Eisbaeeer/Ferraris_MQTT_Energy_Counter_Meter_TCRT5000/(threads)

Thread 1 (2021-02-12):

Lolin V3 freeze

Obsthaendler, 2021-02-12:
Ab und zu friert der esp ein. Dann muss ich immer ein reset machen. Könnte es sein das der eprom Speicher voll läuft?
Nutze einen NodeMCU Lolin V3 Module ESP8266 ESP-12F WIFI

Eisbaeeer, 2021-02-12:
Bisher habe ich keine Probleme feststellen können. Die Counter laufen ohne Watchdog. Und ich bekomme ständig die aktuellen Daten. Bisher konnte ich keine Differenz zu den mechanischem Zähler feststellen. Compiliert wurde mit NodeMCU v.1.0 obwohl auch hier schon die V.3 im Einsatz ist.

Obsthaendler, 2021-02-16:
Danke für die Antwort. Dann muss ich mal auf die Suche gehen, eben hatte ich sogar nach einem Stromreset wieder ein freeze.

Closed 2021-11-12.

Thread 2 (2022-01-21):

Use better MQTT format and announce the device

rmeissn, 2022-01-21:
I'm using mosquitto as a MQTT broker and homeAssistant (HA) for home automation. HA wasn't able to auto discover the energy meter, as it won't announce itself over MQTT and is not using json to report itself as a device (or 4 devices). I had to fiddle with config files and parsing of announces values to get correct entities into HA.
It would be really helpful to announce your device over MQTT and use json to transmit the recorded values. You can find examples at: https://www.home-assistant.io/docs/mqtt/discovery/

Eisbaeeer, 2022-10-17:
Added with last pull-request.

Closed 2022-10-17.

Thread 3 (2022-01-21):

Hide MQTT password

rmeissn, 2022-01-21:
Whenever I visit the config page, the MQTT password is revealed as plain text. It would be more practical to hide the password once it was saved, as other devices are doing this too.

Eisbaeeer, 2022-10-17:
Solved

Closed 2022-10-17.

Thread 4 (2022-01-21):

Add a power per day value

rmeissn, 2022-01-21:
The device is exposing the current energy flow (as kW - it would be more useful to announce it as W) and how much energy has been used since it was installed (as kWh). Providing a daily count would be useful too (in kWh), which resets itself to 0 at 00:00 AM.

Thread 6 (2022-09-14):

Huge spikes in the measured kW

m-kloeckner, 2022-09-14:
Thank you for this project! I tried to achieve the same with ESPHome, but failed to calibrate the sensor. The dashboard with the analog sensor really helps with that.

However, I am still facing issues with bouncing. Sometimes one round results in a spike of the measured kW. See screenshot from my sensor in Home-Assistant.

I already tried adjusting the poti and the debouncing time for the sensor in the configuration. But it's hard to test because the spike only happen sporadically.

How can I best avoid these spikes?
Higher debouncing time? Lower debouncing time?

Thank you!

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

Eisbaeeer, 2022-09-14:
Hallo
Zu diesem Projekt gibt es einen Thread. Dort wird auch auf dieses Problem eingegangen. Grundsätzlich kann man sagen, dass es an dem Sensor liegt. Der Spike entsteht nicht beim Wechsel von rot auf silber, sondern irgendwann zwischendrin. Meist hilft nur, den Sensor mit Bauteilen zu verändern, damit der die Marke sauber erkennt.
Hier der Thread: https://forum.iobroker.net/topic/35404/ferraris-z%C3%A4hler-mit-tcrt5000-und-esp8266
Grüße Lars

m-kloeckner, 2022-09-14:
Danke! Das mit dem Schmitt-Trigger hatte ich auch schon gelesen - führt wahrscheinlich kein Weg dran vorbei. Muss ich allerdings welche bestellen.

Alternativ werde ich mal versuchen den Analog-Ausgang zu nutzen (ich brauche nur einen Zähler am D1 Mini). Ob das besser funktioniert wird sich zeigen: https://github.com/lrswss/esp8266-wifi-power-meter

w00dst0ck, 2022-09-14:
Du könntest Alternativ auch mal diesen Sensor probieren. Hatte damit sehr gute Ergebnisse.
https://forum.iobroker.net/topic/35404/ferraris-z%C3%A4hler-mit-tcrt5000-und-esp8266/367?_=1663145229229

Ich habe zwar mittlerweile einen Digitalen Stromzähler, aber auch da nutze ich den Sensor mit Tasmota um die Datenschnittstelle auszulesen.

m-kloeckner, 2022-09-16:
Kurzes Update: Der oben verlinkte Code läuft nun seit 2 Tagen sehr stabil ohne Hardware-Modifikationen über A0. Vielleicht hilft das jemanden, der nur einen Sensor braucht und mit den digitalen Signalen des TCRT5000 Probleme hat.

Thread 10 (2022-10-16):

Refactor for more flexibility

ss89, 2022-10-16:
Currently for each new meter we want to add, we do need to add a lot of code.

This should be more flexible in my opinion, as in the easiest case i should only have to raise the number of meters and recompile my firmware (maybe not even that?). Depending on the setup of the pins, we'd have to predefine all possible meter to pin configurations.

If we ignore the most flexible way, then i could think of some pre-compiler stuff and we'd be good.

Maybe there is an even smarter way, that doesn't even need pre-compiler magic?

Eisbaeeer, 2022-10-17:
The framework allow flexible pin definitions. Perhaps we can define the pin definitions by dropdown selection. The project starts with one meter. The additional meters where requested by users. Actually there was no user with more the 4 requested. I don´t know if there is a user with >4 ?

ss89, 2022-10-17:
I've seen the history of the project (at least from the iobroker forum entries) and i saw that someone requested 7 meters (which i think should be possible?) here: https://forum.iobroker.net/topic/35404/ferraris-z%C3%A4hler-mit-tcrt5000-und-esp8266/17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
If i see the wiring correctly, then i only need to connect all modules to the same ground and have the digital pin go to an individual pin on the board. For the wemos d1 mini that'd be 9 digital pins => 9 potential meters i could read.
Am i wrong?

I guess a dropdown allows the configuration to be as flexible for the user as possible, i don't know if there is any input validation on the web stuff though. Yet another construction site that i haven't digged into too much 🙈

EtlamGit, 2023-01-22:
I started with refactoring, progress can be followed here:
https://github.com/EtlamGit/Ferraris_MQTT_Energy_Counter_Meter_TCRT5000/tree/refactoring-2023

1) move code into multiple files
2) en-capsule a single Ferraris meter into own class
3) -> enable easy change of number of Ferraris meters

Selection will be at compile time as IOT Framework does not allow dynamic web pages.

Thread 11 (2022-10-16):

Unit of meters should be configurable

ss89, 2022-10-16:
IMHO the unit of the meters should be configurable, so that the end-user can decide which meter they are reading.

In my case I want to put the device in a room where i have one of each:
* power meter
* gas meter
* water meter

Eisbaeeer, 2022-10-17:
Thank´s for pull-request!

ss89, 2022-10-17:
This is a feature request, not a PR 🙈

ss89, 2022-10-17:
Please re-open, because it doesn't let me do it

Eisbaeeer, 2022-10-17:
reopen ;-)

ss89, 2022-10-18:
I am kind of out for this project.
My sensors arrived (mostly damaged).
My energy meter ist not being recognized well enough because in front of the meters glass there is another one from a box of my energy provider and my water meter/gas can also not be read.
Seems i'd have to use some ocr to read it, but i don't believe that is the right way.
Guess i'm waiting until i get smarter meters.

Eisbaeeer, 2022-10-19:
Arghh. Ok. Im out, too. I get smart meters next week. But this project helps others with Ferraries meters.

ss89, 2022-10-20:
Nice! For me there is no ETA yet for getting smart meters

Thread 13 (2022-11-27):

meter counter overflow

Gelbwichtel, 2022-11-27:
Hi, tolles Projekt, schade dass ich erst jetzt darauf gestoßen bin.
Ich hab gerade festgestellt, dass ich mit den kWh von meinem Zähler nicht arbeiten kann, denn dies führt zum Zahlenüberlauf.
Ich muss von **2218269** die beiden ersten Stellen weglassen, damit der Wert noch in einen **int32_t** passt.

Hi, great project, too bad I only came across it now.
I just realized that I can't work with the kWh from my meter, because this leads to number overflow.
I have to leave out the first two digits from **2218269** so that the value still fits into an **int32_t**.

cu
Gelbwichtel

Eisbaeeer, 2022-11-27:
Hi
Du kannst die Variable in der configuration.json einfach größer wählen.
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
Neu compilieren und dein Zählerstand sollte reinpassen.

Gelbwichtel, 2022-12-03:
funktioniert. Danke

Closed 2022-12-03.

Thread 14 (2022-12-12):

NodeMCU disconnect after some time

Bytechanger, 2022-12-12:
For some reason the NodeMCU stop working.
After a while (days) it stops sending data over MQTT and isn´t connected to wlan.
An other device (NodeMCU other firmware at same position) is working well for months.

Eisbaeeer, 2022-12-12:
Hello Bytechanger
This issue is not software related. Please check your MCU or antenna.

Thread 16 (2022-12-13):

0.93 under Dashbord: There are no items defined in the JSON file

bernemer, 2022-12-13:
Hi Eisbaeeer,
under dashbord i get the message : There are no items defined in the JSON file
There is no configuration.

Is there somthing missing in the bin or did i make a mistake?

Eisbaeeer, 2022-12-13:
Are you able to compile the project by yourself with platformio? I think the react enviroment is missing. In this case there is no web-part compiled.

bernemer, 2022-12-13:
At the moment i work with the Ardurino IDE.
Then i will install platformio in in the holidys and test it.

mariusgrams, 2022-12-24:
Same here, not fixed yet

Thread 17 (2023-01-08):

Deaktivierung von unnötigen Zählern

interceptor70, 2023-01-08:
Hallo ich habe mal eine frage ich habe nur einen Zähler und bekomme immer alle angezeigt

gibt es eine Möglichkeit die unnötigen zu deaktivieren ?

LG Gerrit

Eisbaeeer, 2023-01-08:
Es werden immer alle 4 Zähler angezeigt. Spielt aber keine Rolle, da die unbenutzen das System nicht belasten.

Closed 2023-01-08.

Thread 19 (2023-01-24):

OLED

interceptor70, 2023-01-24:
Hallo

Währe es möglich ein OLED Display mit einzubinden

LG Gerrit

EtlamGit, 2023-01-27:
Hallo Gerrit!

Was möchtest Du denn auf dem Display darstellen?

Der Sinn in diesem Projekt ist, den aktuellen Verbrauch zu "zählen" und an einen MQTT-Server zu schicken. Von diesem MQTT-Server kann dann jeder beliebige MQTT-Client die Daten abrufen und auf Wunsch auch auf einem Display anzeigen. Das wäre also ein ESP im dunklen Zählerschrank zum Zählen und ein anderer an gut sichtbarer Stelle mit Display.

interceptor70, 2023-01-28:
zum Beispiel den Sensor zum Einstellen  wäre ja super oder ?
und dann die Sensoren im Wechsel den aktuellen wert

EtlamGit, 2023-01-30:
Zum Einstellen habe ich einfach das Handy daneben gelegt. Genau dafür ist ja das Dashboard da.

Ansonsten gibt es diese Probleme:
* es sind alle Pins reserviert (max 7 Zähler werden unterstützt)
* ich besitze kein Display zum Testen

Thread 22 (2023-02-01):

Support of two TRCT5000 devices per meter to detect direction of meter disc

huckes, 2023-02-01:
With installed solar panels it might happen that the Ferraris Meter runs in reverse order as energy is fed into the electric net if the panels provide more energy as consumed locally. So far the project does not detect the direction change and the energy supplied is counted as consumtion.

With two TCRT5000 modules the rotating direction of the meter disk can be detected by evaluating the detection sequence of the disc mark. This should result in either a message reporting the direction or a negative value of the power calculated or both.

As this project supports several meters with a TCRT-module per each, one approach could be to combine the detection of two TCRT-modules mounted to the screen of one meter.

I already developed a design how to mount two TCRT5000 modules to the meter screen. You can find it in https://www.thingiverse.com/thing:5820811

EtlamGit, 2023-02-01:
Yes, very important note with reverse rotation.
You printed 3D design prevents reading the meter manually. So it might me better to change orientation for both to the bottom or I even read that some people use the sensors in 90°. Have you tested something like that?

A problem I see with supporting two rotation directions is: how to design the configuration dialog?
Because now, each meter is configured separately. When two are combined, we either loose half of the supported number or need some complicated UI. Any ideas how to do that?

huckes, 2023-02-02:
Thanks for your comment and the hint that the plate covers the meter. I posted an additional design on Thingiverse, where the meter can be read. In my case there are two totalizers (day/night-time). The lower totalizer can be read from the side.

Yes, I used the modules as delivered. A hysteresis could make it easier for this project.

I found a schematic of the sensor here: https://www.hotmcu.com/ir-reflective-sensor-tcrt5000-p-184.html
In the schematic the analogue output is missing, but it seems to lead directly to the '-'-input of the OP. With a resistor between OP-output and '+'-input a hysteresis could be implemented, as far as I can remember my electronic lessones ages ago.
But for a general purpose module the possibillity to adjust the hysteries were needed too. And two potentiometers would interfere each other in this easy case.

I had also some problems to find a mounting position to reduce false detection. Therefore I tried to find the best position for the optocouplers. In my case it resulted in mounting the optocouplers in horizontal orientation to the disc to minimize reflections from the 'silver'-cover plate. And the reason for one module top of and the other one below the disc is to bring both opto-transistors as near as possible to the middle and the IR-leds right and left from these. With this mounting I had the best results of clear detection vs. false detection. Therefor I skipped the options to mount the modules side by side or 90° turned by.

I could not discover oscillation. But there might occur false detection due to unround disc or reflections of the disc teeth, if it is this, what you mean.
A false detection lasts usually only a short time in relation to the detection of the disc mark. These false detections could be elimited by defining a minimum length of detection duration. And addtionally a transit of the disc causes also a concurrent detection period of both modules over a minimum duration.

In case of really oscillating output I would try to bridge a small capacitator betwenn VCC and ground directly at the TCRT-modules.

I must confess I did'nt looked up the code in detail so far, so false detection might be filtered already. I'm still struggeling a bit with getting the cloned projet running on my PIO installation. The installation of the iot-framework causes error messages which I could not solve so far due to the fact that I'm a fairly new PIO-user.

huckes, 2023-02-02:
Hi again, concerning support of two rotation direction i forgot to comment:

On a first step it probably could be possible to combine only explicitly two input channels (e.g. the first and the last) as an option to be selected by e.g. compiler switch. Then only one channel gets lost and the effort to be done changing the UI could be postponed if this option is wanted by other users too. Calibration of the second sensor involved can be done by changing the wires without changing the UI. The introduction of a '-'-character or another mark for revers rotation is not a severe problem for the UI, i hope.

EtlamGit, 2023-02-05:
So many (good) topics you address . . . I will try to answer them during the next weeks.

Just to give some background: I just started using this project some weeks ago. The original author does not have a Ferraris meter anymore, so it would be task of others to continue. I still struggle with stability issues (WLAN, oscillation) but since yesterday I think I have solved them.

I like the idea to be able to count in both directions.

Regarding the oscillations:
Others call them bouncing, but this is not mechanical bouncing as this would have a defined time duration and could be solved with typical de-bouncing techniques.
Just imagine the meter is turning very very slow. Then the change between silver to red is not a hard cut, but a very slow slope. At the input of the comparator you will get any intermediate voltage for any time duration (it has just to be slow enough).
As the comparator is wired in simple comparator mode, a threshold is set via the potentiometer. At the moment the incoming analog value from the IR detector is reaching the threshold, the comparator will change output state. This will change the green LED, which will change the current consumption of the sensor. This will cause a supply voltage drop/rise that may change the operation point of the comparator. So it will switch again, what will change the supply voltage which will change . . .
As conclusion: if the meter is slow enough, it is possible that the output will toggle at any arbitrary frequency for any arbitrary time. It is impossible to de-bounce that. The only solution is an analog hysteresis for the comparator.
And you remember right, it is just a resistor (100k ..1M) from + to out. With that simple solution it is not possible to get a defined hysteresis, but at least something in that direction. For a real and well designed hysteresis you would have to place another resistor in front of the + input. But the layout of the sensor prevents easy access to that wire.

huckes, 2023-02-06:
Thanks a bunch for your reply and that you will continue working on that project.

My Ferraris energy counter will be replaced by a modern type latest in 2027.

I also detected bouncing you described during the beginninng and the end of the red-zone-passing. Of course more visible during slow speed, but I could see this also on higher speed, if the sensors were mounted unhandy. As soon as the red-zone covered most of the sensor, this bouncing stoped.

Excuse me please if I write too much stuff already known or considered:

One fact which might be less considered: The sensor is a reflective sensor mainly to detect a certain distance.However, in this project it is used to detect a colour change. During the 'silver'-phase it shall detect 'near' (LED on), during the 'red'-phase it shall detect far (LED off). So the principle used is, that the red zone (hopefully) reflects less IR-light than the silver zone.
To do this with a fairly good reliabillity the sensor should 'see' the disc and as less as possible the plate covering the innards of the energy-counter.

Thats the reason why I put a mask over the sensor LED, to reduce the IR-light projected to the plate (not completely, but noticeable).
With my way of mounting I could measure on the analogue pin a voltage-ratio of about 1:1,5 in best case (1,2V silver, 1,8V red).
The better this ratio the fewer the bounces.

I just measured the current used by the sensor: 15,4 mA with LED off and 17.2 mA with LED on. So the LED uses less than 2 mA. If this 2 mA leads to the effect you described due to power drop, I assume either a weak power source or too long or too thin cables. Nethertheless for testing purpose I would bridge the power pins of the sensor with a capacitor of some µF and perhaps a high frequency blocking capacitor with some nF. If this does not help removing the LED or it's series resistor should work.

I dropped two videos to youtube with slow and fast disc speed (+ 2,1 KW) with my test installation.

Low speed:  https://youtu.be/MF94PpN3KXA
Fast speed: https://youtu.be/FgT2etckv6I

I'm still struggeling get the code running on my PIO installation. Following the intallation guide of the esp8266-iot-framework still ends up with error messages. Other esp8266-based code I tried could be compliled and uploaded successfully. I'll keep trying ....

EtlamGit, 2023-02-08:
Very interesting.
I get a voltage difference of only 25mV ! Even with optimal mounting position.
It is possible to control the mounting with a digital camera. You can see the IR light and if it gets reflected or not with an old smartphone (my new one has an IR filter). And I can clearly see the reflected light from silver and darkness for the red mark.
I also tried your lightshade, no effect at all.
(New sensors are ordered)

huckes, 2023-02-08:
25mV seems to be insufficient.

Reasons beside mounting could be:
- weak TCRT-Modules,
- geometric problems e.g. the slot is too narrow so too much light is reflected by the plate or the distance between disc and pane ist to far,
- optical reason: the red zone reflects IR-light nearly as good as the silver zone.

You must ensure, that the TCRT modules are mounted directly to the pane.
In annother article a user put pieces of shrink tube over the IR-led and the opto-trans.

A proffessional solution were to put a lense in front of the IR-led.

EtlamGit, 2023-06-15:
Hallo Hans, sorry dass ich so lange beschäftigt war! Aber ich musste zuerst meinen Zähler überhaupt zum Zählen bringen und danach dafür sorgen, dass er zum Testen auch mal rückwärt läuft.

Finally I solved my voltage difference issue and can count now. It needed several TCRT5000 modules and in the end I had to design and manufacture my own board. Probably my glass cover is disturbing the IR light.

My new board is out of the box capable of dual direction counting!
I will start testing to count in dual directions from now on.

EtlamGit, 2023-06-19:
I assume the Shelly will work more stable. But they are quite expensive.

First tests here look promising with nice counting in both directions.
Thank you for the idea of this feature!

Eisbaeeer, 2023-07-12:
solved with PR #23

Closed 2023-07-12.

Thread 24 (2023-10-13):

Exception on NodeMcu v3 when opening captive portal in browser

phija, 2023-10-13:
Hi,

I try to make this project run on my NodeMcu v3 and can build and deploy it using PlatformIO without any issues.
My goal is to have later 2 TCRT5000 connected to measure on a single Ferraris counter but with 2 directional detection.

The problem starts when opening the captive portal in the browser to enter my personal Wifi connection data.

My steps to reproduce
1. restart the NodeMcu and start Serial Monitor (in VS Code): message says "Opened a captive portal", blue LED is on.
2. connect to wifi "Ferraris MQTT": browser opens automatically the 192.168.4.1 with showing the Wifi settings

when the page has loaded, immediately the serial monitor shows an unhandled C++ exception and the whole NodeMcu crashes and restarts:

The exception starts like this:
```
Opened a captive portal
192.168.4.1

User exception (panic/abort/assert)
--------------- CUT HERE FOR EXCEPTION DECODER ---------------

Unhandled C++ exception: OOM

>>>stack>>>

ctx: sys
sp: 3fffedf0 end: 3fffffb0 offset: 0010
3fffee00:  3fffb05c 4021993c 00000144 4022e896
3fffee10:  00000000 3fff1684 3fffb05c 4021993c
...
```

and the bottom of the stack trace shows the beginning always like this:

```
...
0x4027fef0 in pm_wakeup_init at ??:?
0x4021164c in WiFiUDP::parsePacket() at C:\Users\***\.platformio\packages\framework-arduinoespressif8266\libraries\ESP8266WiFi\src/WiFiUdp.cpp:198
0x40233dec in PubSubClient::connected() at .pio\libdeps\nodemcuv2\PubSubClient\src/PubSubClient.cpp:689
0x402299d9 in PubSubClient::loop() at .pio\libdeps\nodemcuv2\PubSubClient\src/PubSubClient.cpp:371
0x402069f5 in WifiManager::loop() at .pio\libdeps\nodemcuv2\ESP8266 IoT Framework\src/WiFiManager.cpp:245
0x4020aef9 in loop at src/main.cpp:370 (discriminator 2)
0x4020b0ab in setup at src/main.cpp:306
0x40100680 in ets_post at C:\Users\***\.platformio\packages\framework-arduinoespressif8266\cores\esp8266/core_esp8266_main.cpp:238
0x401006a1 in esp_schedule at C:\Users\***\.platformio\packages\framework-arduinoespressif8266\cores\esp8266/core_esp8266_main.cpp:136
0x4022ecca in loop_wrapper() at C:\Users\***\.platformio\packages\framework-arduinoespressif8266\cores\esp8266/core_esp8266_main.cpp:264

last failed alloc call: 40219778(324)

--------------- CUT HERE FOR EXCEPTION DECODER ---------------

last failed alloc caller: 0x40219778

 ets Jan  8 2013,rst cause:2, boot mode:(3,6)

load 0x4010f000, len 3424, room 16
tail 0
chksum 0x2e
load 0x3fff20b8, len 40, room 8
tail 0
chksum 0x2b
csum 0x2b
v000f1190
~ld
```

How can I make it run without crashing?
Any help is appreciated!

Eisbaeeer, 2023-10-13:
You have to debug the dump to find the error. There are several how to in web to debug the dump. Greets LarsVon meinem/meiner Galaxy gesendet
-------- Ursprüngliche Nachricht --------Von: phija ***@***.***> Datum: 13.10.23  13:27  (GMT+01:00) An: Eisbaeeer/Ferraris_MQTT_Energy_Counter_Meter_TCRT5000 ***@***.***> Cc: Subscribed ***@***.***> Betreff: [Eisbaeeer/Ferraris_MQTT_Energy_Counter_Meter_TCRT5000] Exception on NodeMcu v3 when opening captive portal in browser (Issue #24)
Hi,
I try to make this project run on my NodeMcu v3 and can build and deploy it using PlatformIO without any issues.
My goal is to have later 2 TCRT5000 connected to measure on a single Ferraris counter but with 2 directional detection.
The problem starts when opening the captive portal in the browser to enter my personal Wifi connection data.
My steps to reproduce

restart the NodeMcu and start Serial Monitor (in VS Code): message says "Opened a captive portal", blue LED is on.
connect to wifi "Ferraris MQTT": browser opens automatically the 192.168.4.1 with showing the Wifi settings

when the page has loaded, immediately the serial monitor shows an unhandled C++ exception and the whole NodeMcu crashes and restarts:
The exception starts like this:
Opened a captive portal
192.168.4.1

User exception (panic/abort/assert)
--------------- CUT HERE FOR EXCEPTION DECODER ---------------

Unhandled C++ exception: OOM

>>>stack>>>

ctx: sys
sp: 3fffedf0 end: 3fffffb0 offset: 0010
3fffee00:  3fffb05c 4021993c 00000144 4022e896
3fffee10:  00000000 3fff1684 3fffb05c 4021993c
...

and the bottom of the stack trace shows the beginning always like this:
0x4027fef0 in pm_wakeup_init at ??:?
0x4021164c in WiFiUDP::parsePacket() at C:\Users\jarvers\.platformio\packages\framework-arduinoespressif8266\libraries\ESP8266WiFi\src/WiFiUdp.cpp:198
0x40233dec in PubSubClient::connected() at .pio\libdeps\nodemcuv2\PubSubClient\src/PubSubClient.cpp:689
0x402299d9 in PubSubClient::loop() at .pio\libdeps\nodemcuv2\PubSubClient\src/PubSubClient.cpp:371
0x402069f5 in WifiManager::loop() at .pio\libdeps\nodemcuv2\ESP8266 IoT Framework\src/WiFiManager.cpp:245
0x4020aef9 in loop at src/main.cpp:370 (discriminator 2)
0x4020b0ab in setup at src/main.cpp:306
0x40100680 in ets_post at C:\Users\jarvers\.platformio\packages\framework-arduinoespressif8266\cores\esp8266/core_esp8266_main.cpp:238
0x401006a1 in esp_schedule at C:\Users\jarvers\.platformio\packages\framework-arduinoespressif8266\cores\esp8266/core_esp8266_main.cpp:136
0x4022ecca in loop_wrapper() at C:\Users\jarvers\.platformio\packages\framework-arduinoespressif8266\cores\esp8266/core_esp8266_main.cpp:264

last failed alloc call: 40219778(324)

--------------- CUT HERE FOR EXCEPTION DECODER ---------------

last failed alloc caller: 0x40219778

 ets Jan  8 2013,rst cause:2, boot mode:(3,6)

load 0x4010f000, len 3424, room 16
tail 0
chksum 0x2e
load 0x3fff20b8, len 40, room 8
tail 0
chksum 0x2b
csum 0x2b
v000f1190
~ld

How can I make it run without crashing?
Any help is appreciated!

—Reply to this email directly, view it on GitHub, or unsubscribe.You are receiving this because you are subscribed to this thread.Message ID: ***@***.***>

phija, 2023-10-13:
Thanks for the hint.
It seems to be the MQTT configuration which I didn't take care. If I comment out that parts in the setup() it works until the next mqtt methods are called in the loop().
Funny, this is the part I wanted us come around with by using a datalogger shield anyway because my Ferraris counter has no private wifi available. So I need to rewrite some parts in my fork.
Good enough for me then!

For anybody else: without having things setup and configured correctly (like MQTT), it might be crashing...

Closed 2023-10-13.
