Eisbaeeer/Ferraris_MQTT_Energy_Counter_Meter_TCRT5000/(commit log)

2021-08-22 Version 0.7
    Nachkommastellen hinzugefügt
    Bugfixes
    [main.cpp]
2021-09-14 Version 0.8
    Added interrupt routines
2021-10-14 Version 0.9.2
    Bugfixes see README.md
    [main.cpp]
2022-10-14 added d1 devices as build environments incl. ci
2023-01-19 harmonize indent
    no functional change, only code style:
    + harmonize indent to be the same (2 spaces) across the file
    + fix indent for several if and switch statements
    + use same style of brackets for all if/for and switch statements
    [main.cpp]
2023-01-21 improve WiFi stability
    + enable reconnect after WiFi loss
    + feed watchdog during long running functions
    + skip dashboard and MQTT update when WiFi is not connected
    + leave interrupts on when MQTT reconnect will be not done this cycle
    [main.cpp]
2023-01-25 add headers to group dashboard and configuration
    + add Header lines to group parameters for each meter
    + use label to get more meaningful text
    + update dynamic part dashboard only when a client is connected to web-server
    + use blue LED to show lost WiFi
2023-01-27 do not print in IQR handler
    IRQ handler should return as fast as possible and never use shared resources. We would have to print somewhere else.
    Rename source files.
2023-01-30 move Ferraris meter code into objects
    + use "Ferraris" objects to capsule code and state for each meter
    + allow 1 .. 7 meters just by one #define
    + switch from [kW] -> [W] for live consumption, so we do not need float there
    + use the count of revolutions as source of total consumption [kWh] to allow fractional part there and no float in IRQ handler
2023-02-10 restart stuck WiFi
    In some circumstances the WiFi status gets stuck at WL_IDLE_STATUS, resulting in a dead connection.
    This change tries to detect this case and restarts WiFi to recover.
    [main.cpp]
